htfab/breakout-ttsky-cob/README.md

# Tiny Tapeout COB ETR pcb (TT08)

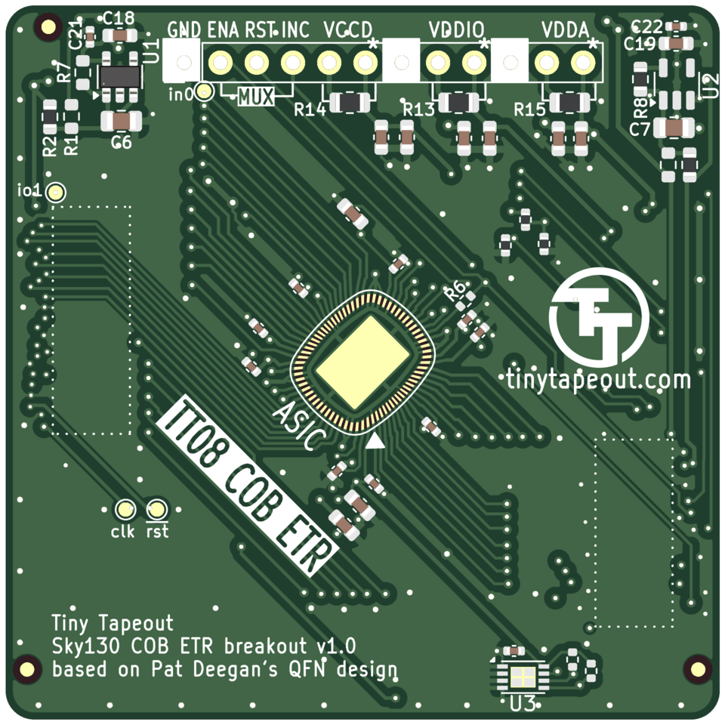
[picture p1: images/top.png]
&emsp;
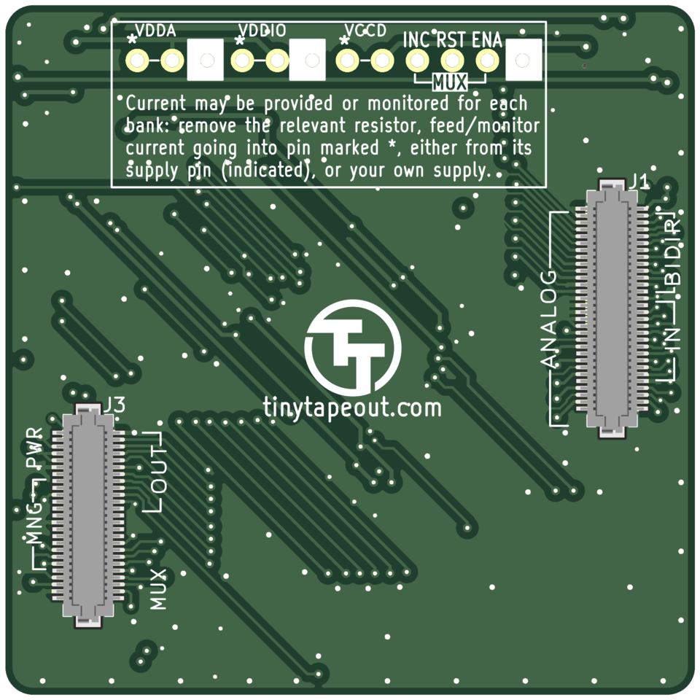
[picture p2: images/bottom.png]
