htfab/breakout-ttsky-cob/breakout-ttsky-cob.kicad_sch

## KiCad design breakout-ttsky-cob.kicad_sch (2026-03-03)

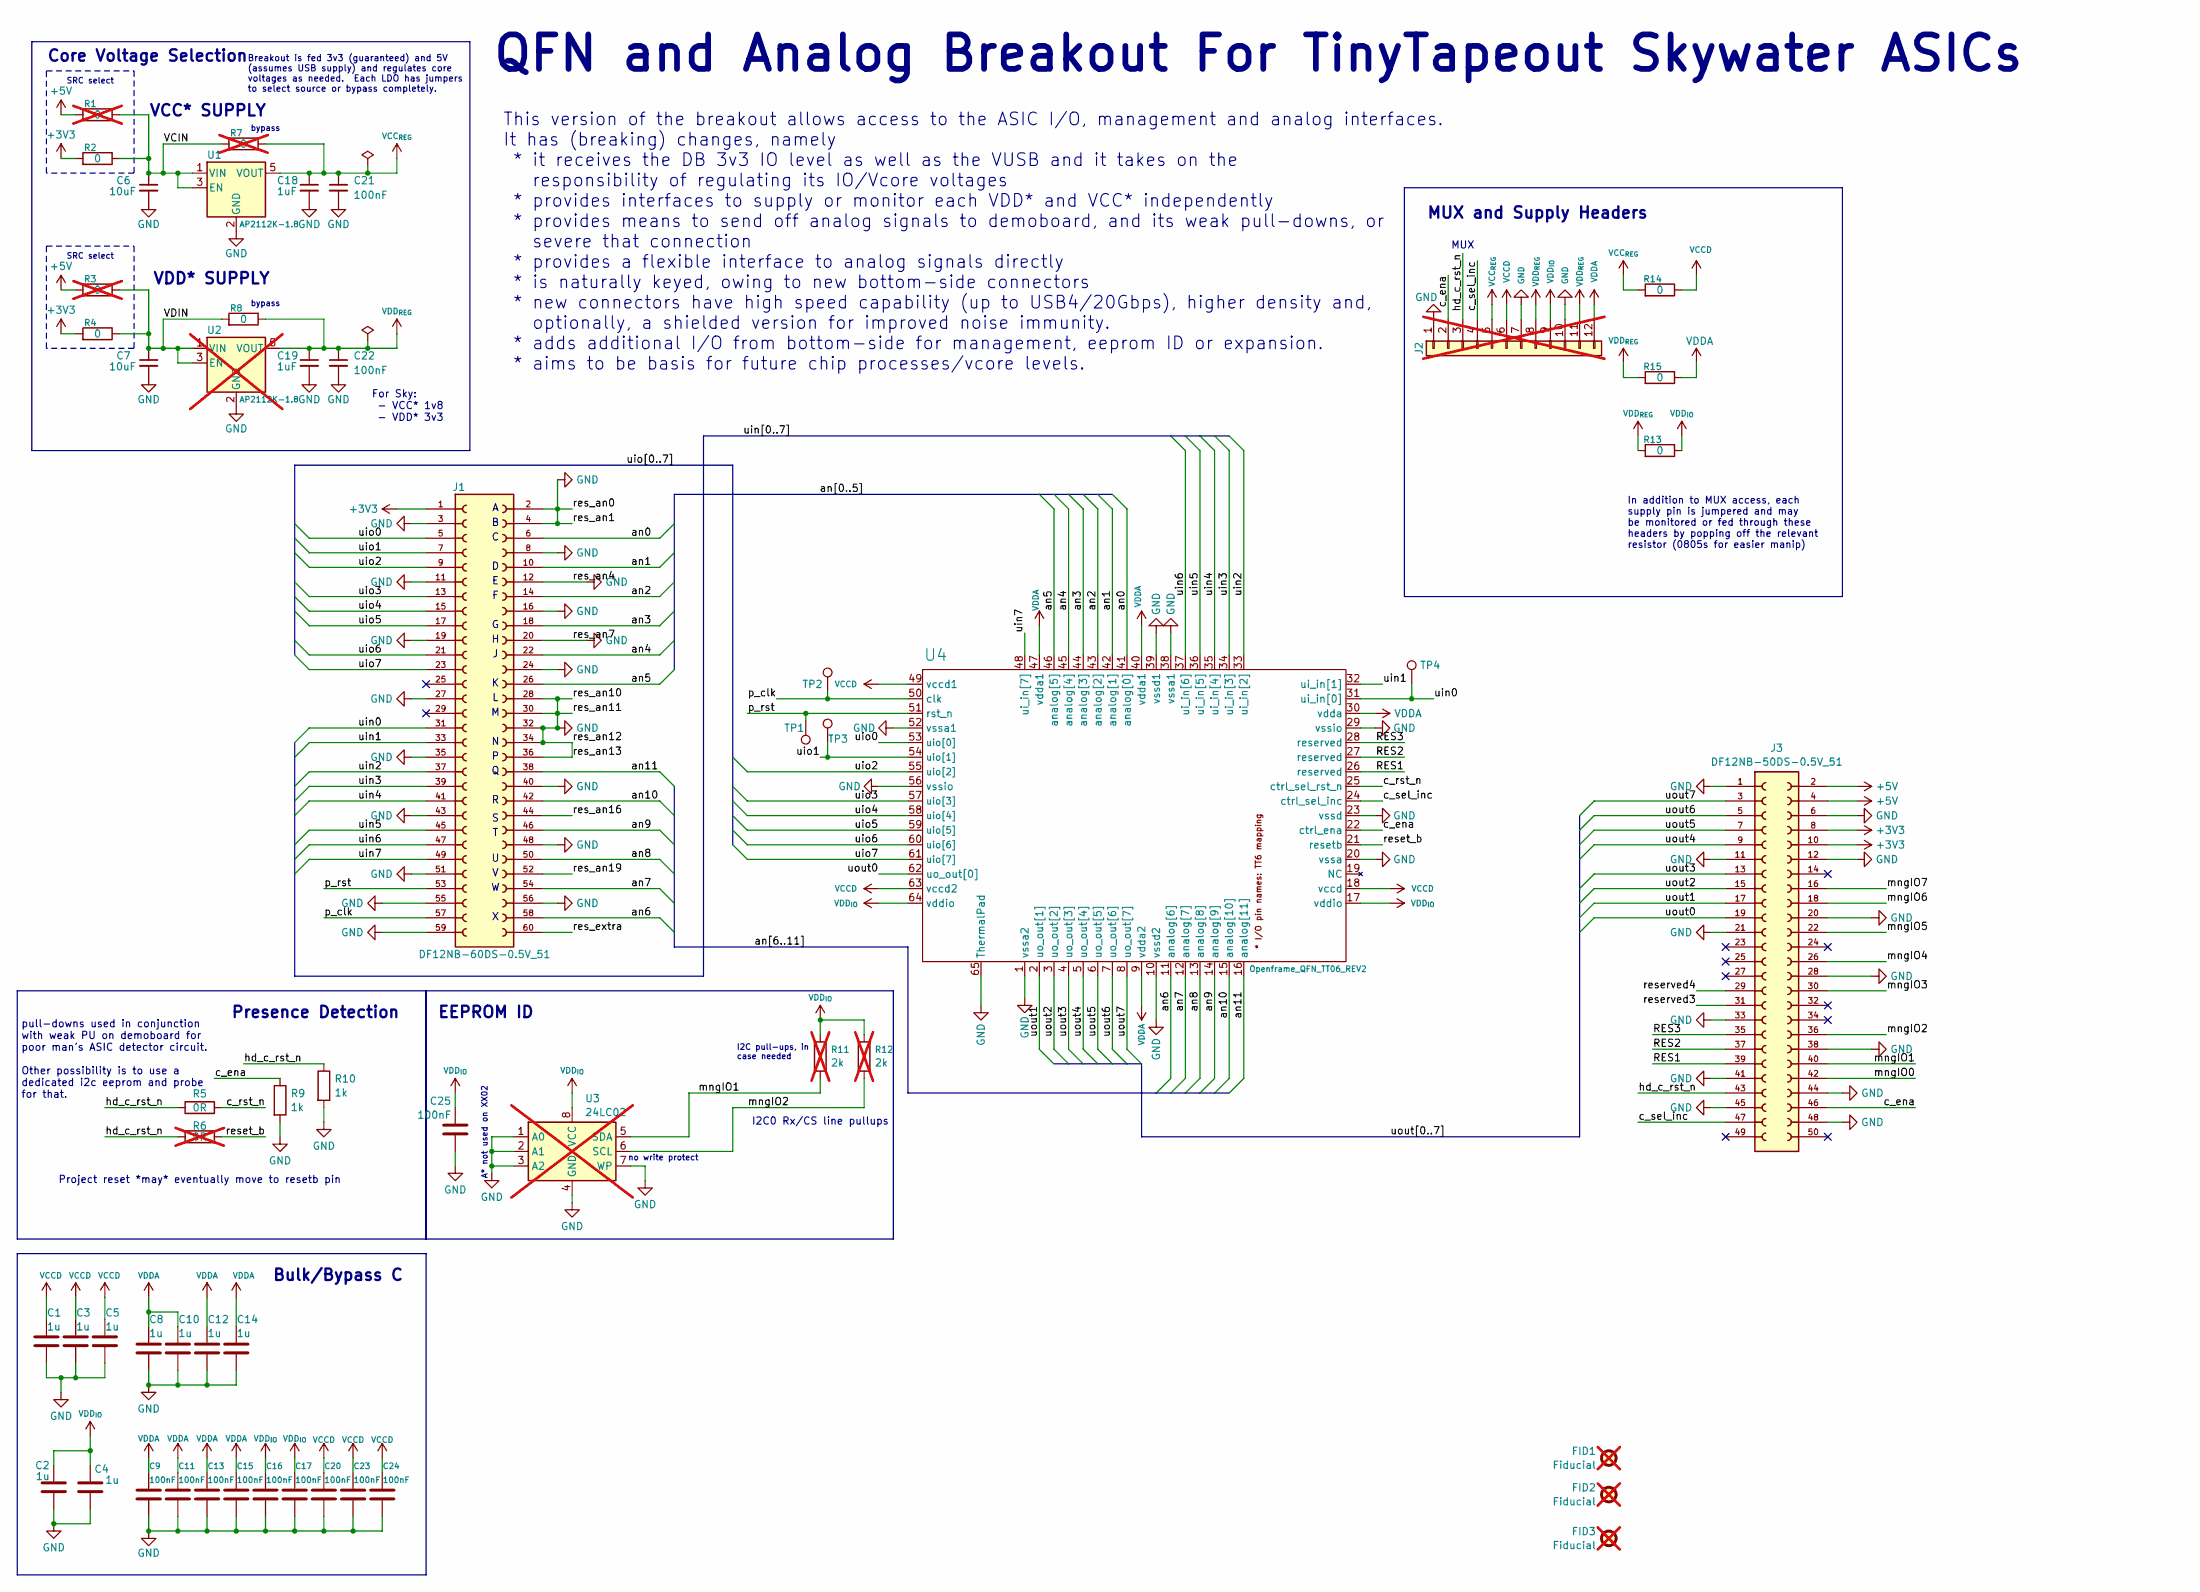
[picture p3: schematic breakout-ttsky-cob.kicad_sch]

Parts:
C1, C2, C3, C4, C5, C8, C10, C12, C14: 1uF; C_0603_1608Metric; MPN GRT188R61H105KE13D; DigikeyPN 490-12330-1-ND
C6, C7: 10uF; C_0805_2012Metric; MPN GRM21BR71C106KE51L; LCSC C408142
C9, C11, C13, C15, C16, C17, C20, C21, C22, C23, C24, C25: 100nF; C_0402_1005Metric; MPN CL05A104KA5NNNC; LCSC C100072
C18, C19: 1uF; C_0603_1608Metric; MPN GRT188R61H105KE13D; LCSC C5673
FID1, FID2, FID3: Fiducial; Fiducial_1mm_Mask2mm; not fitted
J1: DF12NB-60DS-0.5V_51; HRS_DF12NB-60DS-0.5V_51; MPN DF12NB-60DS-0.5V(51); DigikeyPN 26-DF12NB-60DS-0.5V(51)CT-ND
J2: Conn_01x12; PinHeader_1x12_P2.54mm_Vertical; not fitted
J3: DF12NB-50DS-0.5V_51; HRS_DF12NB-50DS-0.5V_51; MPN DF12NB-50DS-0.5V(51); DigikeyPN 26-DF12NB-50DS-0.5V(51)CT-ND
R1, R3, R7: 0; R_0603_1608Metric; MPN CRG0603ZR; DigikeyPN A106051CT-ND; not fitted
R2, R4, R8: 0; R_0603_1608Metric; MPN CRG0603ZR; DigikeyPN A106051CT-ND
R5: 0R; R_0402_1005Metric; MPN RC0402JR-070RL; DigikeyPN 311-0.0JRCT-ND
R6: 0R; R_0402_1005Metric; MPN RC0402JR-070RL; DigikeyPN 311-0.0JRCT-ND; not fitted
R9, R10: 1k; R_0402_1005Metric; MPN CR0402-FX-1001GLF; LCSC C11702
R11, R12: 2k; R_0402_1005Metric; MPN RC0402FR-072KL; DigikeyPN 311-2KLRCT-ND; not fitted
R13, R14, R15: 0; R_0805_2012Metric; MPN RC0805JR-100RL; DigikeyPN 13-RC0805JR-100RLCT-ND
TP1, TP2, TP3, TP4: TestPoint; TestPoint_Pad_D1.0mm
U1: AP2112K-1.8; SOT-23-5; MPN AP2112K-1.8TRG1; DigikeyPN AP2112K-1.8TRG1DICT-ND
U2: AP2112K-1.8; SOT-23-5; MPN AP2112K-1.8TRG1; DigikeyPN AP2112K-1.8TRG1DICT-ND; not fitted
U3: 24LC02; DFN-8-1EP_3x2mm_P0.5mm_EP1.75x1.45mm; MPN 24LC02BT-I/MC; DigikeyPN 24LC02BT-I/MCCT-ND; not fitted
U4: Openframe_QFN_TT06_REV2; caravel_cob_100_105; MPN TT_ASIC; LCSC TT_ASIC_CHIP

Connections:
+3V3: J1.1, J3.8, J3.10, R2.1, R4.1
+5V: J3.2, J3.4, R1.1, R3.1
GND: C1.2, C2.2, C3.2, C4.2, C5.2, C6.2, C7.2, C8.2, C9.1, C10.2, C11.1, C12.2, C13.1, C14.2, C15.2, C16.2, C17.1, C18.2, C19.2, C20.1, C21.2, C22.2, C23.2, C24.1, C25.1, J1.2, J1.3, J1.4, J1.8, J1.11, J1.12, J1.16, J1.19, J1.20, J1.24, J1.27, J1.28, J1.30, J1.32, J1.34, J1.35, J1.36, J1.40, J1.43, J1.48, J1.51, J1.55, J1.56, J1.59, J2.1, J2.7, J2.10, J3.1, J3.6, J3.11, J3.12, J3.20, J3.21, J3.28, J3.33, J3.38, J3.41, J3.44, J3.45, J3.48, R9.2, R10.2, U1.2 (GND), U2.2 (GND), U3.1 (A0), U3.2 (A1), U3.3 (A2), U3.4 (GND), U3.7 (WP), U4.1 (vssa2), U4.10 (vssd2), U4.20 (vssa), U4.23 (vssd), U4.29 (vssio), U4.38 (vssa1), U4.39 (vssd1), U4.52 (vssa1), U4.56 (vssio), U4.65 (ThermalPad)
RES1: J3.39, U4.26 (reserved)
RES2: J3.37, U4.27 (reserved)
RES3: J3.35, U4.28 (reserved)
VCCD: C1.1, C3.1, C5.1, C20.2, C23.1, C24.2, J2.6, R14.2, U4.18 (vccd), U4.49 (vccd1), U4.63 (vccd2)
VCC_{REG}: C18.1, C21.1, J2.5, R7.2, R14.1, U1.5 (VOUT)
VCIN: C6.1, R1.2, R2.2, R7.1, U1.1 (VIN), U1.3 (EN)
VDDA: C8.1, C9.2, C10.1, C11.2, C12.1, C13.2, C14.1, C15.1, J2.12, R15.2, U4.9 (vdda2), U4.30 (vdda), U4.40 (vdda1), U4.47 (vdda1)
VDD_{IO}: C2.1, C4.1, C16.1, C17.2, C25.2, J2.9, R11.1, R12.1, R13.2, U3.8 (VCC), U4.17 (vddio), U4.64 (vddio)
VDD_{REG}: C19.1, C22.1, J2.8, J2.11, R8.2, R13.1, R15.1, U2.5 (VOUT)
VDIN: C7.1, R3.2, R4.2, R8.1, U2.1 (VIN), U2.3 (EN)
an0: J1.6, U4.41 (analog[0])
an1: J1.10, U4.42 (analog[1])
an2: J1.14, U4.43 (analog[2])
an3: J1.18, U4.44 (analog[3])
an4: J1.22, U4.45 (analog[4])
an5: J1.26, U4.46 (analog[5])
an6: J1.58, U4.11 (analog[6])
an7: J1.54, U4.12 (analog[7])
an8: J1.50, U4.13 (analog[8])
an9: J1.46, U4.14 (analog[9])
an10: J1.42, U4.15 (analog[10])
an11: J1.38, U4.16 (analog[11])
c_ena: J2.2, J3.46, R9.1, U4.22 (ctrl_ena)
c_rst_n: R5.2, U4.25 (ctrl_sel_rst_n)
c_sel_inc: J2.4, J3.47, U4.24 (ctrl_sel_inc)
hd_c_rst_n: J2.3, J3.43, R5.1, R6.1, R10.1
mngIO0: J3.42
mngIO1: J3.40, R11.2, U3.5 (SDA)
mngIO2: J3.36, R12.2, U3.6 (SCL)
mngIO3: J3.30
mngIO4: J3.26
mngIO5: J3.22
mngIO6: J3.18
mngIO7: J3.16
p_clk: J1.57, TP2.1, U4.50 (clk)
p_rst: J1.53, TP1.1, U4.51 (rst_n)
res_an16: J1.44
res_an19: J1.52
res_extra: J1.60
reserved3: J3.31
reserved4: J3.29
reset_b: R6.2, U4.21 (resetb)
uin0: J1.31, TP4.1, U4.31 (ui_in[0])
uin1: J1.33, U4.32 (ui_in[1])
uin2: J1.37, U4.33 (ui_in[2])
uin3: J1.39, U4.34 (ui_in[3])
uin4: J1.41, U4.35 (ui_in[4])
uin5: J1.45, U4.36 (ui_in[5])
uin6: J1.47, U4.37 (ui_in[6])
uin7: J1.49, U4.48 (ui_in[7])
uio0: J1.5, U4.53 (uio[0])
uio1: J1.7, TP3.1, U4.54 (uio[1])
uio2: J1.9, U4.55 (uio[2])
uio3: J1.13, U4.57 (uio[3])
uio4: J1.15, U4.58 (uio[4])
uio5: J1.17, U4.59 (uio[5])
uio6: J1.21, U4.60 (uio[6])
uio7: J1.23, U4.61 (uio[7])
uout0: J3.19, U4.62 (uo_out[0])
uout1: J3.17, U4.2 (uo_out[1])
uout2: J3.15, U4.3 (uo_out[2])
uout3: J3.13, U4.4 (uo_out[3])
uout4: J3.9, U4.5 (uo_out[4])
uout5: J3.7, U4.6 (uo_out[5])
uout6: J3.5, U4.7 (uo_out[6])
uout7: J3.3, U4.8 (uo_out[7])

Notes on the sheet:
Presence Detection
Bulk/Bypass C
I2C pull-ups, in case needed
MUX
pull-downs used in conjunction with weak PU on demoboard for poor man's ASIC detector circuit. Other possibility is to use a dedicated i2c eeprom and probe for that.
For Sky: - VCC* 1v8 - VDD* 3v3
Breakout is fed 3v3 (guaranteed) and 5V (assumes USB supply) and regulates core voltages as needed. Each LDO has jumpers to select source or bypass completely.
I2C0 Rx/CS line pullups
A* not used on XX02
MUX and Supply Headers
bypass
VCC* SUPPLY
SRC select
In addition to MUX access, each supply pin is jumpered and may be monitored or fed through these headers by popping off the relevant resistor (0805s for easier manip)
Project reset *may* eventually move to resetb pin
VDD* SUPPLY
no write protect
This version of the breakout allows access to the ASIC I/O, management and analog interfaces. It has (breaking) changes, namely * it receives the DB 3v3 IO level as well as the VUSB and it takes on the responsibility of regulating its IO/Vcore voltages * provides interfaces to supply or monitor eac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
Core Voltage Selection
EEPROM ID
QFN and Analog Breakout For TinyTapeout Skywater ASICs
