htfab/breakout-ttsky-cob/(commit log)

2026-03-03 add initial version
    [breakout-ttsky-cob.kicad_pcb, breakout-ttsky-cob.kicad_sch]
2026-03-03 remove overlapping U4 label
    [breakout-ttsky-cob.kicad_pcb]
2026-03-03 add extra ground & edit widths
    [breakout-ttsky-cob.kicad_pcb]
2026-03-03 fix violation from changed width
    [breakout-ttsky-cob.kicad_pcb]
2026-03-03 setup for production
    [breakout-ttsky-cob.kicad_pcb]
2026-03-03 generate production files
    [bom.csv, designators.csv, positions.csv]
