htfab/breakout-ttsky-cob/(notices)

Notices in the files:
breakout-ttsky-cob.kicad_sch:
(C) 2025 Pat Deegan
